Georgebruh/Vantage-System/outputs/power-board/Vantage_Power_BOM.csv

Item | Qty | References | Value | Package / part
1 | 1 | BT1 | 18650 1S | JST B2B-XH-A to the 18650 pack lead
2 | 2 | C1 C7 | 220uF 16V | radial electrolytic 6.3 mm, 2.5 mm pitch
3 | 4 | C2 C4 C5 C8 | 100nF | 1206 (3216)
4 | 1 | C3 | 220uF 10V | radial electrolytic 6.3 mm, 2.5 mm pitch
5 | 2 | C6 C9 | 10uF | 1206 (3216)
6 | 1 | D1 | SMAJ9.0CA | SMA (DO-214AC), bidirectional TVS
7 | 1 | D2 | SS34 | SMA (DO-214AC), 3 A Schottky
8 | 1 | F1 | PTC 1.5A | 1812 PTC, 1.5 A hold
9 | 1 | J1 | SENSOR | JST B6B-XH-A (XH 6-pin, vertical)
10 | 1 | J2 | SOLAR 6V | 2-way screw terminal, 5.08 mm
11 | 1 | J3 | I2C | 1x4 male header 2.54 mm
12 | 1 | JP1 | BAT_ISO | 1x2 male header 2.54 mm + jumper cap
13 | 1 | M1 | CN3791 MPPT 6V | CN3791 MPPT charger module, 6 V panel
14 | 1 | M2 | BMS 1S | 1S Li-ion protection (BMS) module
15 | 1 | M3 | TPS63020 3V3 | TPS63020 buck-boost module, 3.3 V out
16 | 1 | M4 | BOOST 5V | 5 V boost module
17 | 1 | R1 | 10k | 1206 (3216)
18 | 2 | R2 R3 | 4.7k | 1206 (3216)
19 | 1 | TP1 | VBAT | test pad
20 | 1 | TP2 | 3V3 | test pad
21 | 1 | TP3 | 5V | test pad
22 | 1 | TP4 | GND | test pad
23 | 1 | U1 | INA226 0x40 | INA226 module, address 0x40 (solar)
24 | 1 | U2 | INA226 0x44 | INA226 module, address 0x44 (battery)
25 | 1 | U3 | LM66100 | LM66100 ideal diode, SC-70-6
26 | 1 | U4 | TPS2051B | TPS2051B power switch, SOT-23-5
