Georgebruh/Vantage-System/outputs/sensor-board/Vantage_Sensor_BOM.csv

Item | Qty | References | Value | Package | Mounted on
1 | 1 | C1 | 10uF | 1206 (3216), X7R/X5R, >=10 V | copper side (SMD)
2 | 1 | C2 | 22uF | 1206 (3216), X7R/X5R, >=10 V | copper side (SMD)
3 | 1 | C3 | 1uF | 1206 (3216), X7R/X5R, >=10 V | copper side (SMD)
4 | 1 | C4 | 100nF | 1206 (3216), X7R/X5R, >=10 V | copper side (SMD)
5 | 1 | D1 | SS14 | SMA (DO-214AC) | copper side (SMD)
6 | 1 | D2 | SMAJ6.0A | SMA (DO-214AC) | copper side (SMD)
7 | 1 | F1 | PTC 0.2A | 1812 (4532) | copper side (SMD)
8 | 2 | H1 H2 | M3 | M3 screw + standoff (no part on the PCB) | -
9 | 1 | J1 | POWER | JST S6B-XH-A (XH 6-pin, side entry) | component side (THT)
10 | 1 | J2 | AJ-SR04M | 1x4 female header 2.54 mm | component side (THT)
11 | 1 | J3 | BME280 | 1x6 female header 2.54 mm | component side (THT)
12 | 1 | J4 | RAIN | 2-way screw terminal, 3.5 mm pitch | component side (THT)
13 | 1 | J5 | TF-Luna | 1x4 male header 2.54 mm | component side (THT)
14 | 1 | JP1 | 3V3 FEED | 1x2 male header 2.54 mm + jumper cap | component side (THT)
15 | 1 | JP2 | BENCH 5V | 1x2 male header 2.54 mm + jumper cap | component side (THT)
16 | 4 | R1 R4 R5 R11 | 1k | 1206 (3216) | copper side (SMD)
17 | 1 | R2 | 10k | 1206 (3216) | copper side (SMD)
18 | 1 | R3 | 18k | 1206 (3216) | copper side (SMD)
19 | 1 | R6 | 100R | 1206 (3216) | copper side (SMD)
20 | 2 | R7 R8 | 220R | 1206 (3216) | copper side (SMD)
21 | 1 | U1 | ESP32-S3-DevKitC-1 N16R8 | 2x 1x22 female header 2.54 mm, rows 25.4 mm apart | component side (THT)
