Georgebruh/Vantage-System/outputs/power-board/Vantage_Power_Schematic.pdf

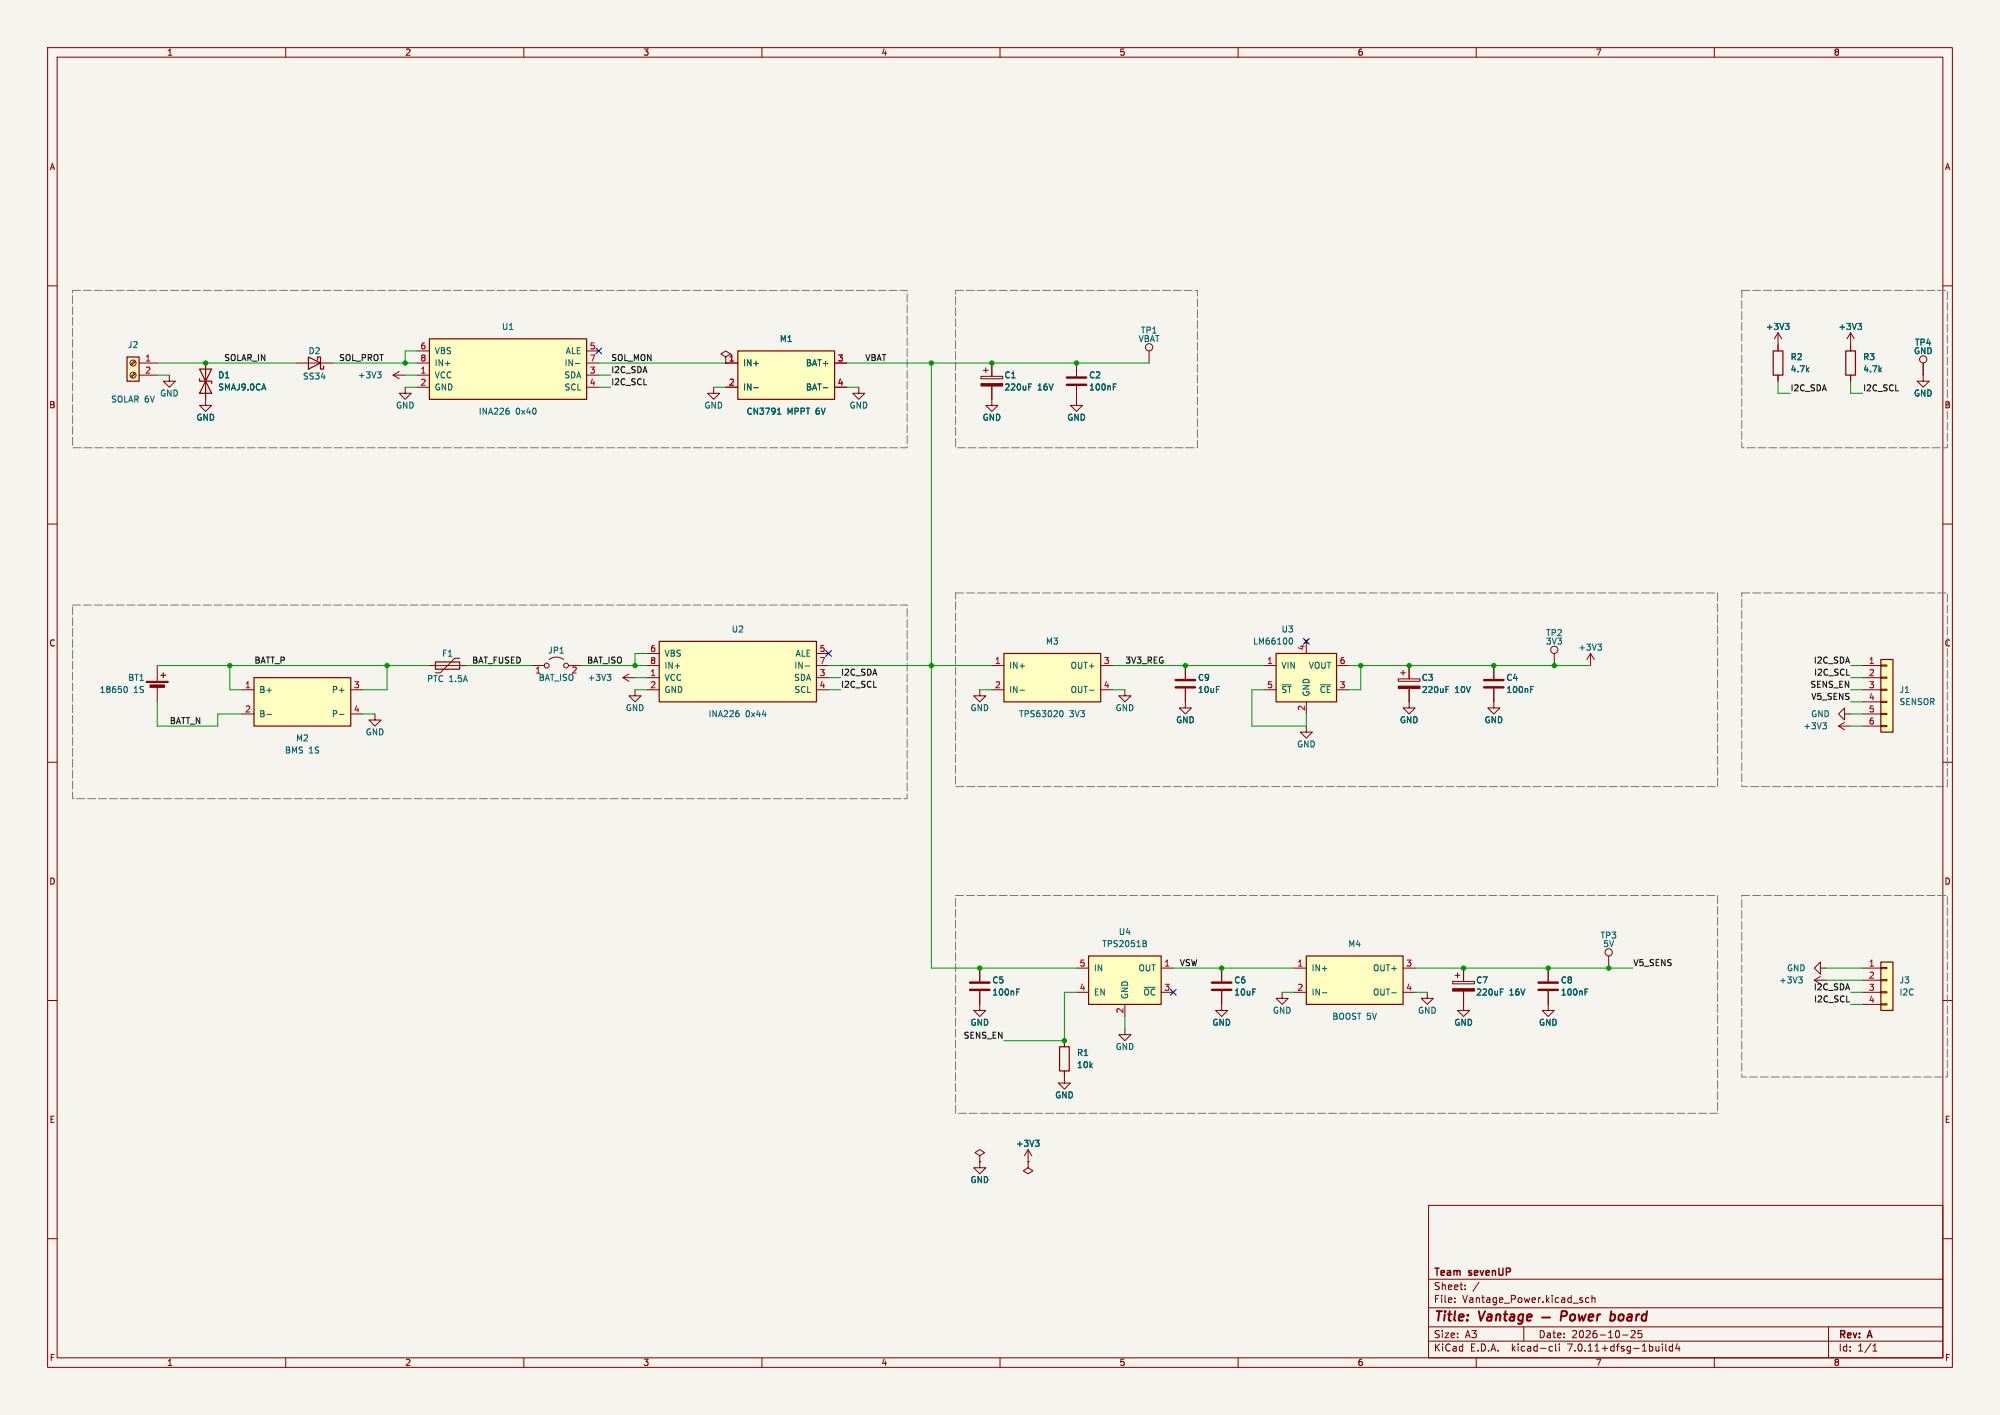
[picture p3: page 1]

File: Vantage_Power.kicad_sch Sheet: / Team sevenUP

Id: 1/1 Title: Vantage þÿ Power board
