Georgebruh/Vantage-System/outputs/sensor-board/Vantage_Sensor_Assembly-Drawing.pdf

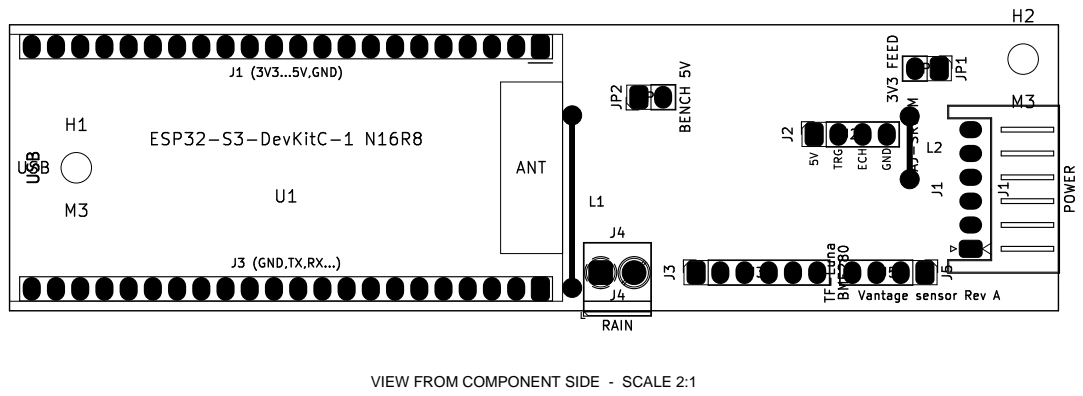
[picture p4: page 1]

VIEW FROM COMPONENT SIDE - SCALE 2:1

File: Vantage_Sensor.kicad_pcb Sheet: Team sevenUP

Id: 1/1 Title: Vantage þÿ Sensor board

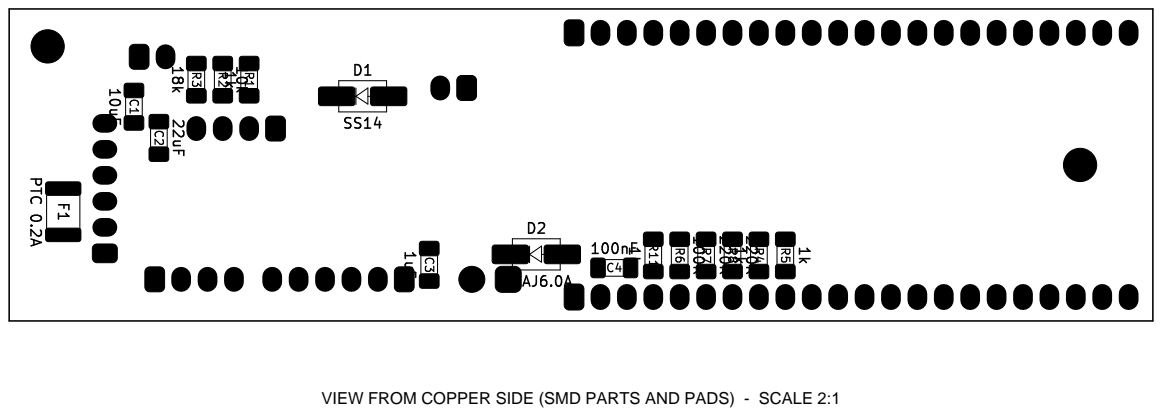
[picture p5: page 2]

VIEW FROM COPPER SIDE (SMD PARTS AND PADS) - SCALE 2:1

Id: 1/1 Title: Vantage þÿ Sensor board
