Georgebruh/Vantage-System/outputs/sensor-board/Vantage_Sensor_Schematic.pdf

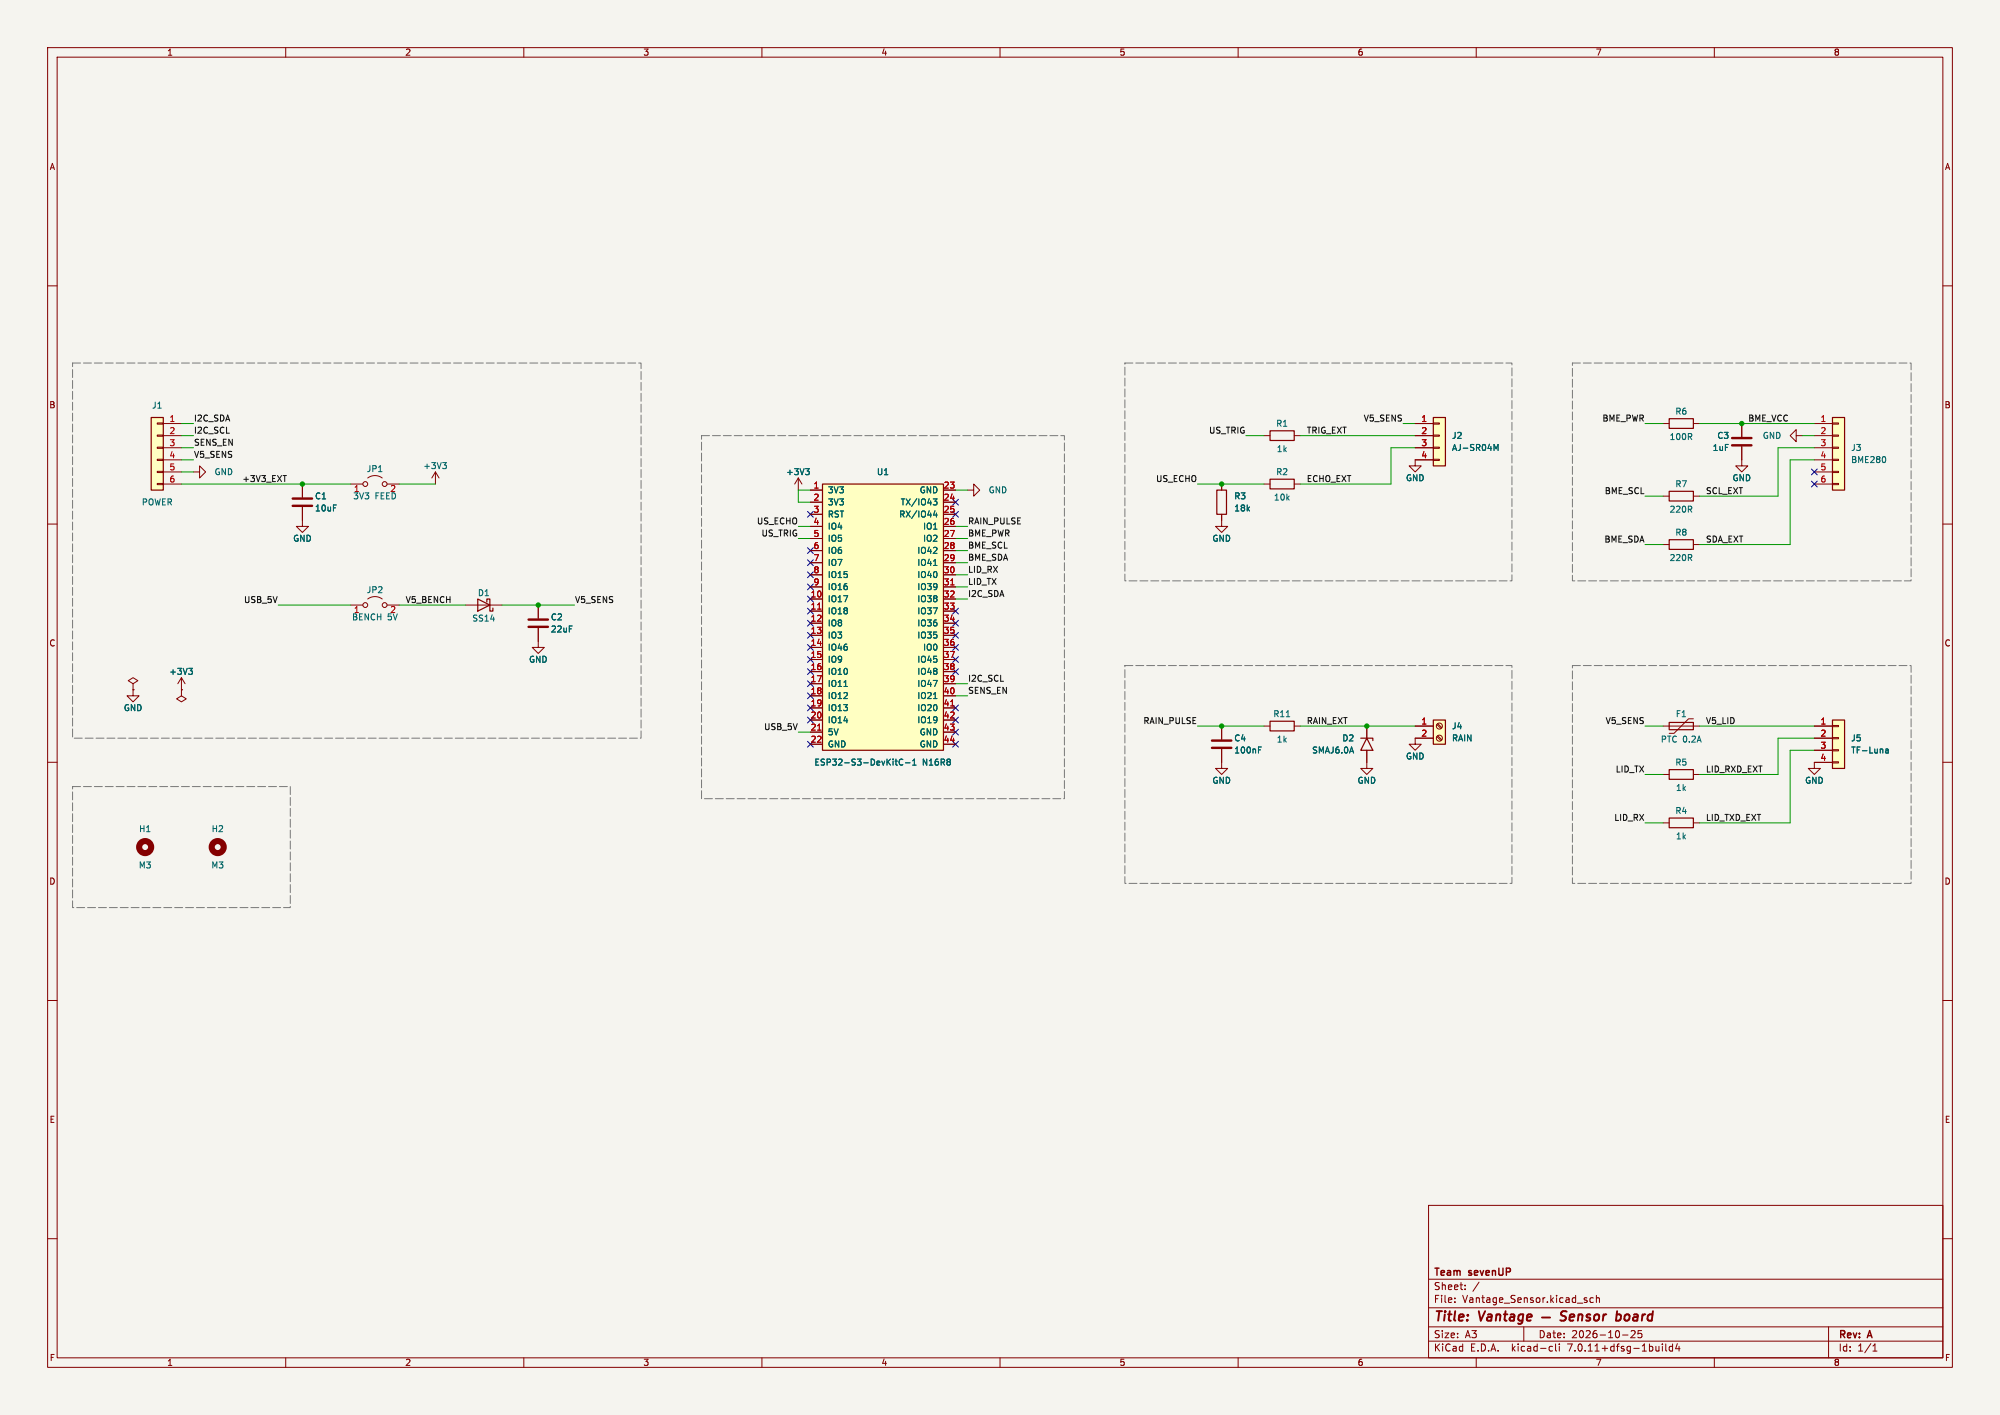
[picture p6: page 1]

File: Vantage_Sensor.kicad_sch Sheet: / Team sevenUP

Id: 1/1 Title: Vantage þÿ Sensor board
