Georgebruh/Vantage-System/outputs/sensor-board/Vantage_Sensor_Copper-Artwork_A4.pdf

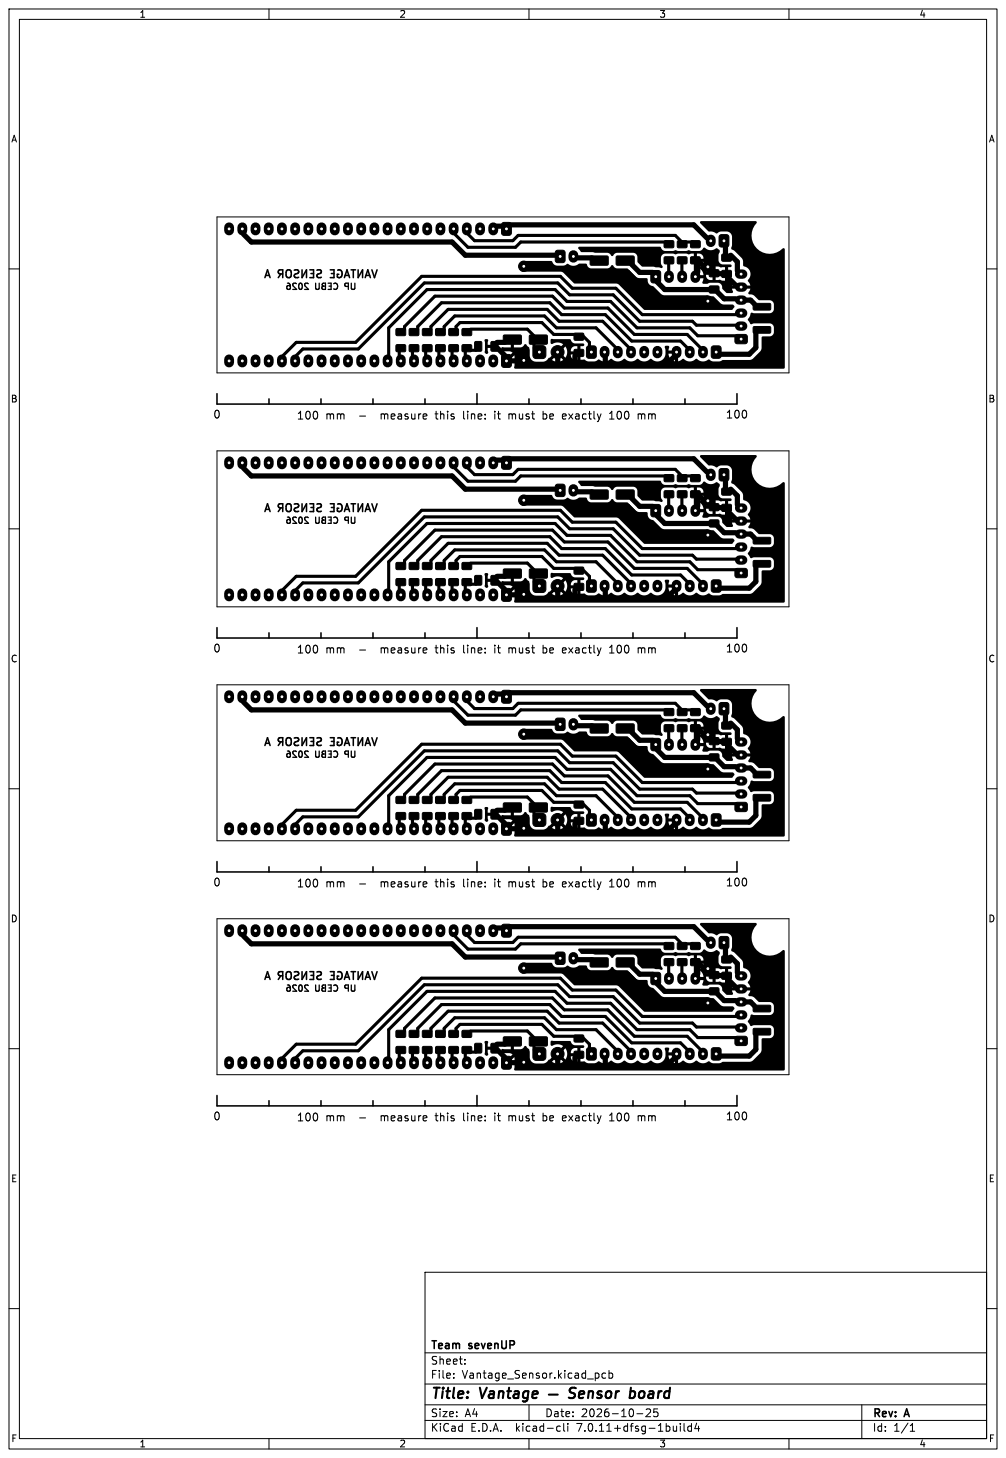
[picture p7: page 1]
F Date: 2026-10-25 KiCad; kicad-cli; 7.0.11+dfsg-1build4 Size: A4; Rev: A

File: Vantage_Sensor.kicad_pcb Sheet: Team sevenUP

Id: 1/1 Title: Vantage þÿ Sensor board
