Georgebruh/Vantage-System/sensor-board/Vantage_Sensor.kicad_pcb

## KiCad design sensor-board/Vantage_Sensor.kicad_pcb (2026-10-25)

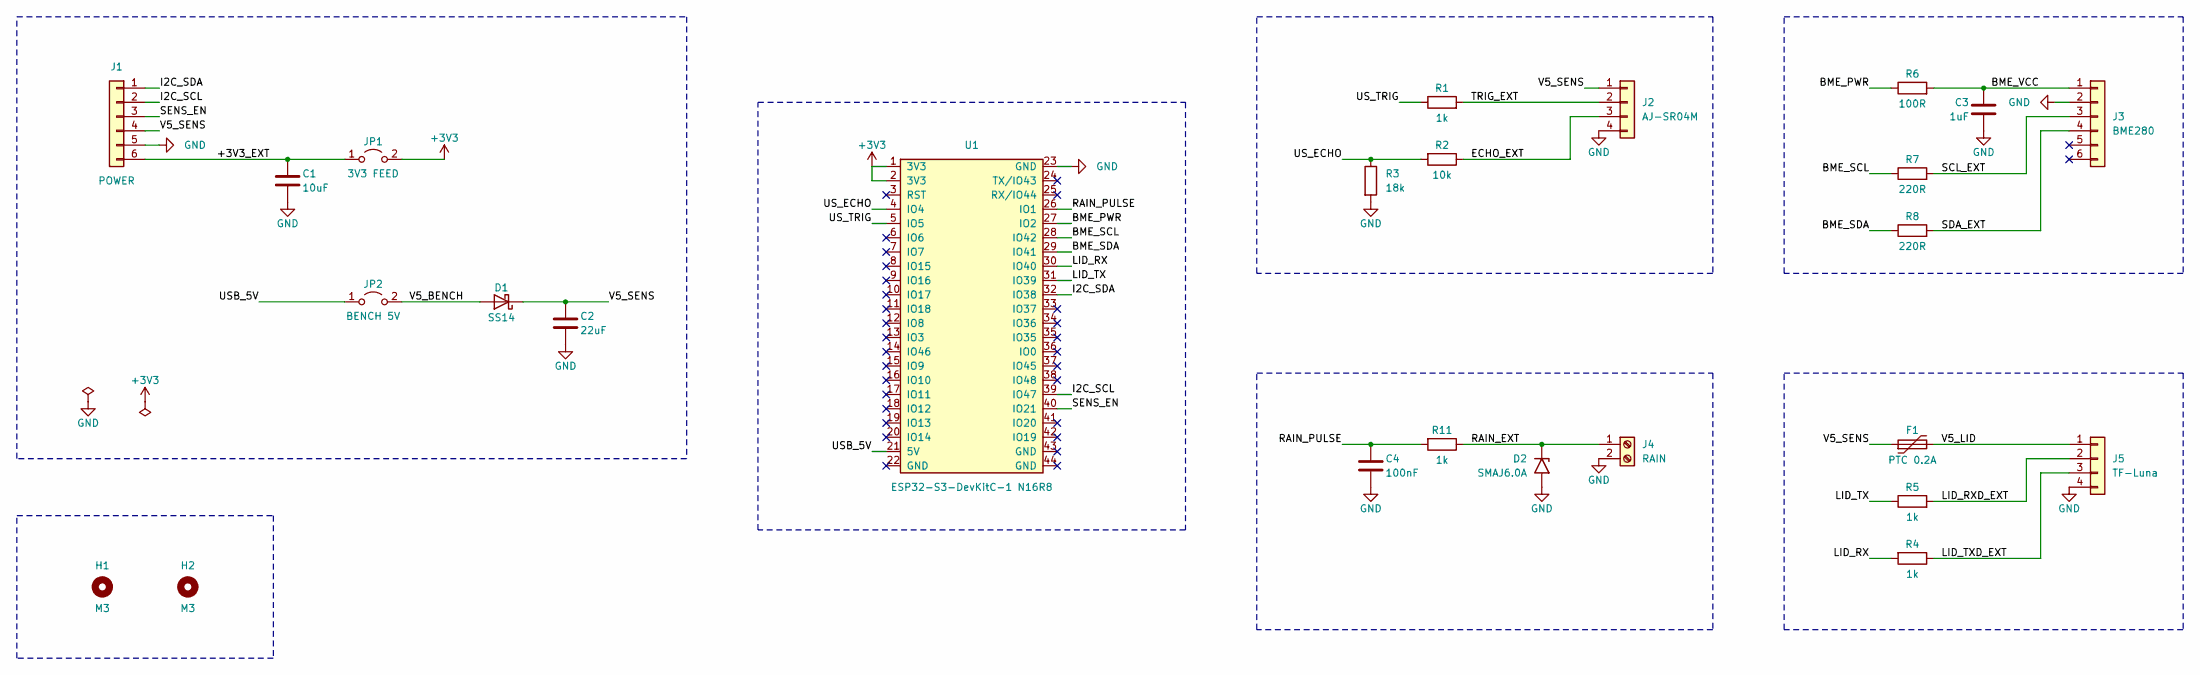
[picture p9: schematic Vantage_Sensor.kicad_sch, Vantage — Sensor board]

Parts:
C1: 10uF; C_1206_HandSolder_Bottom
C2: 22uF; C_1206_HandSolder_Bottom
C3: 1uF; C_1206_HandSolder_Bottom
C4: 100nF; C_1206_HandSolder_Bottom
D1: SS14; D_SMA_HandSolder_Bottom
D2: SMAJ6.0A; D_SMA_HandSolder_Bottom
F1: PTC 0.2A; Fuse_1812_HandSolder_Bottom
H1, H2: M3; MountingHole_3.2mm_M3_KeepCopper3.5mm
J1: POWER; JST_XH_S6B-XH-A_1x06_P2.50mm_Horizontal_Toner
J2: AJ-SR04M; AJ-SR04M_Socket_1x04_Upright
J3: BME280; PinSocket_1x06_P2.54mm_Vertical_Toner
J4: RAIN; TerminalBlock_3.5mm_1x02_Toner
J5: TF-Luna; PinHeader_1x04_P2.54mm_Vertical_Toner
JP1: 3V3 FEED; PinHeader_1x02_P2.54mm_Vertical_Toner
JP2: BENCH 5V; PinHeader_1x02_P2.54mm_Vertical_Toner
R1, R4, R5, R11: 1k; R_1206_HandSolder_Bottom
R2: 10k; R_1206_HandSolder_Bottom
R3: 18k; R_1206_HandSolder_Bottom
R6: 100R; R_1206_HandSolder_Bottom
R7, R8: 220R; R_1206_HandSolder_Bottom
U1: ESP32-S3-DevKitC-1 N16R8; ESP32-S3-DevKitC-1_Socket_Row25.40mm

Connections:
+3V3: JP1.2 (B), U1.1 (3V3), U1.2 (3V3)
/+3V3_EXT: C1.1, J1.6, JP1.1 (A)
/BME_PWR: R6.1, U1.27 (IO2)
/BME_SCL: R7.1, U1.28 (IO42)
/BME_SDA: R8.1, U1.29 (IO41)
/BME_VCC: C3.1, J3.1, R6.2
/ECHO_EXT: J2.3, R2.1
/I2C_SCL: J1.2, U1.39 (IO47)
/I2C_SDA: J1.1, U1.32 (IO38)
/LID_RX: R4.2, U1.30 (IO40)
/LID_RXD_EXT: J5.2, R5.2
/LID_TX: R5.1, U1.31 (IO39)
/LID_TXD_EXT: J5.3, R4.1
/RAIN_EXT: D2.1 (A1), J4.1, R11.1
/RAIN_PULSE: C4.1, R11.2, U1.26 (IO1)
/SCL_EXT: J3.3, R7.2
/SDA_EXT: J3.4, R8.2
/SENS_EN: J1.3, U1.40 (IO21)
/TRIG_EXT: J2.2, R1.2
/USB_5V: JP2.1 (A), U1.21 (5V)
/US_ECHO: R2.2, R3.1, U1.4 (IO4)
/US_TRIG: R1.1, U1.5 (IO5)
/V5_BENCH: D1.2 (A), JP2.2 (B)
/V5_LID: F1.2, J5.1
/V5_SENS: C2.1, D1.1 (K), F1.1, J1.4, J2.1
GND: C1.2, C2.2, C3.2, C4.2, D2.2 (A2), J1.5, J2.4, J3.2, J4.2, J5.4, R3.2, U1.23 (GND)

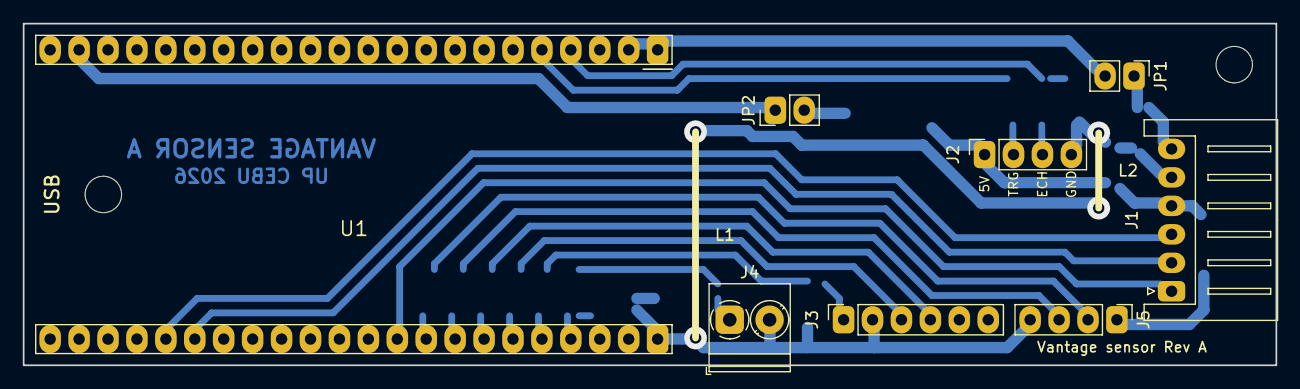
[picture p10: board Vantage_Sensor.kicad_pcb from above]

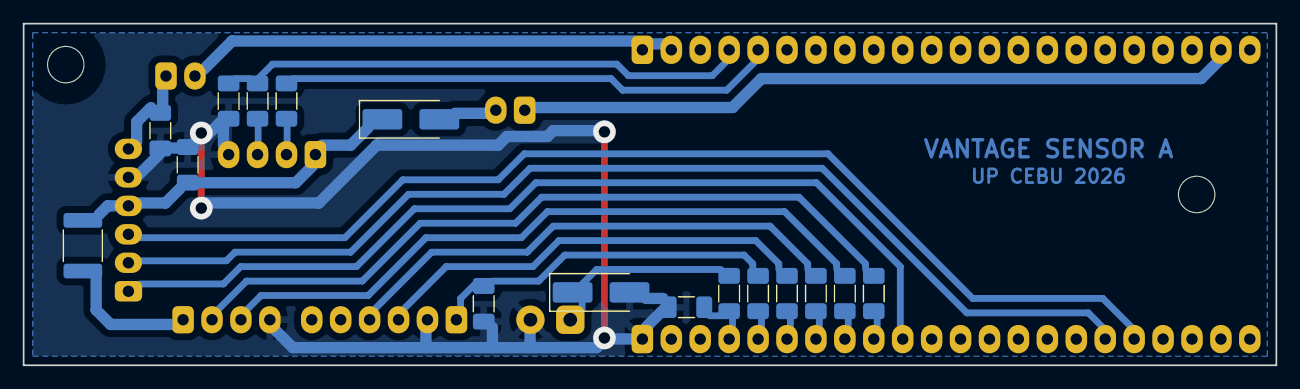
[picture p11: board Vantage_Sensor.kicad_pcb from below]

Board: 2 copper layers, 110.0 x 30.0 mm, 26 parts (16 on the bottom side), 26 nets.
