Georgebruh/Vantage-System/firmware/include/pins.h

#pragma once

// VNT-001 Annex C, Table C.5
constexpr int PIN_RAIN = 1;
constexpr int PIN_BME_PWR = 2;
constexpr int PIN_US_ECHO = 4;
constexpr int PIN_US_TRIG = 5;
constexpr int PIN_SENS_EN = 21;
constexpr int PIN_PWR_SDA = 38;
constexpr int PIN_LID_TX = 39;
constexpr int PIN_LID_RX = 40;
constexpr int PIN_BME_SDA = 41;
constexpr int PIN_BME_SCL = 42;
constexpr int PIN_PWR_SCL = 47;

constexpr uint8_t INA_SOLAR_ADDR = 0x40;
constexpr uint8_t INA_BATT_ADDR = 0x44;
