Georgebruh/Vantage-System/(commit log)

2026-10-25 Rev A: sensor and power board design files, drawings and documents
    [Vantage_Power.kicad_sch, Vantage_Power_BOM.csv, Vantage_Sensor.kicad_pcb, Vantage_Sensor.kicad_sch, Vantage_Sensor_BOM.csv, Vantage_Sensor_Drill.csv]
2026-10-28 Firmware 0.1.0: ESP32-S3 node firmware for all sensors
    BME280, AJ-SR04M, TF-Luna, rain gauge and both INA226 monitors, with
    battery-based power modes, storm mode, deep sleep, queued uploads to
    the gateway and a bench build for the VNT-001 functional tests.
